ye8um/Chordial/README.md

# Chordial 🎹



## What is Chordial?

Chordial is a small, portable electronic instrument that lets you play musical chords with just a turn and a press of a knob. I wanted to create something that makes playing chords simple and fun, even for someone who doesn't know much about music theory.

Instead of having a full keyboard with dozens of keys, Chordial uses a rotary encoder to choose a chord. Once you've found the chord you want, you can press the knob to hear it play through a built-in speaker.

The whole instrument is designed to fit inside a compact 3D printed enclosure, making it easy to keep on a desk or bring around.

## Why I Made It

I've always found it interesting how different musical notes can come together to create a completely different sound. However, most musical instruments take quite a bit of practice to learn.

That gave me the idea of making an instrument that could play entire chords without needing to learn complicated finger positions.

I also wanted to challenge myself by designing my own PCB, figuring out how electronic components work together, and creating an enclosure that would make everything feel like one complete product.

Chordial combines my interests in music, electronics, programming, and 3D modeling into one project.

## How It Works

Chordial is controlled using two main inputs: a rotary encoder and a mechanical key.

Turning the rotary encoder scrolls through 24 different chords, including all 12 major chords and all 12 minor chords. The selected chord appears on a small OLED display, along with its notes and playback duration.

Pressing the rotary encoder plays the selected chord through the speaker. The sound is generated by the ESP32 and sent to a MAX98357A amplifier, which drives the speaker.

The mechanical key changes how long the chord plays. There are four duration settings: 0.5 seconds, 1 second, 2 seconds, and 4 seconds.

The goal is to make the controls simple enough that anyone can pick up Chordial and start experimenting with different sounds.

## Hardware

Chordial uses a Seeed Studio XIAO ESP32 S3 as its main microcontroller. It handles the rotary encoder, OLED display, and audio generation.

The display is a 128 × 64 SSD1306 OLED, which shows the current chord and its settings.

For sound, I chose a MAX98357A digital audio amplifier connected to an 8 ohm speaker. This allows the instrument to play multiple notes simultaneously and produce a soft, sustained synth sound.

The controls consist of an EC11 rotary encoder with a built-in push button and a Cherry MX compatible mechanical switch.

Chordial is powered by a rechargeable 3.7 V LiPo battery. It also includes a slide switch for controlling battery power, while the XIAO provides USB C connectivity.

All the electronics are designed to fit onto a custom PCB that I made in KiCad.



## Enclosure Design

I designed the enclosure in Fusion 360 with the goal of making Chordial compact, comfortable, and easy to use.

The top has openings for the OLED, rotary encoder, mechanical key, and speaker grille. I also added the Chordial name and an acoustic guitar engraving to give the instrument a little more personality.

The enclosure consists of separate top and bottom pieces that are secured using screws and nuts. The bottom contains compartments for the battery and speaker.

I also plan to use a custom 3D printed rotary knob so the instrument feels more comfortable to control.



## Software

The firmware is written in Arduino C++ for the XIAO ESP32 S3.



It reads the rotary encoder to determine which chord is selected, updates the OLED display, and generates the audio signals needed to play each chord.

Instead of relying on prerecorded audio files, Chordial generates the musical notes directly through code. This means the instrument doesn't need an SD card or stored sound samples.

The firmware currently includes 24 major and minor chords, with four selectable playback durations.

## Building Chordial

I started by creating the schematic and PCB layout in KiCad. This involved figuring out how to connect the microcontroller, amplifier, display, switches, speaker, and battery.

After finishing the PCB design, I created the enclosure in Fusion 360. I had to consider the placement and height of each component to make sure everything would fit together properly.

The firmware was then developed to control the chord selection, display, and sound generation.

The next part of the project is assembling the electronics, testing the firmware on the physical hardware, and making any adjustments needed.

## Bill of Materials

[BOM](BOM.csv)
