ye8um/Chordial/BOM.csv

Item | Qty | Supplier | Cost/item | Total Cost | link
ESP32-S3 | 1 | Seeed Studio | $7.49 | $7.49 | https://www.seeedstudio.com/XIAO-ESP32S3-p-5627.html
0.96 inch Oled Display | 1 | Aliexpress | $1.09 | $1.09 | https://www.aliexpress.us/item/3256806514513498.html
PEC11R-4220F-S0024 | 1 | Digikey | $2.69 | $2.69 | https://www.digikey.com/en/products/detail/bourns-inc/PEC11R-4220F-S0024/4499660
MAX98357A | 1 | Digikey | $4.08 | $4.08 | https://www.digikey.com/en/products/detail/analog-devices-inc-maxim-integrated/MAX98357AETE-T/4936122
Adafruit Industries-Speakers-3923 | 1 | Digikey | $5.95 | $5.95 | https://www.digikey.com/en/products/detail/adafruit-industries-llc/3885/10481842
BATTERY LITH-ION 3.7V 500MAH | 1 | Digikey | $7.95 | $7.95 | https://www.digikey.com/en/products/detail/adafruit-industries-llc/1578/5054539
Molex0532610271 | 1 | Digikey | $0.60 | $0.60 | https://www.digikey.com/en/products/detail/molex/0532610271/699094
JST-PH S2B-PH-K-S | 1 | Digikey | $0.12 | $0.12 | https://www.digikey.com/en/products/detail/jst-sales-america-inc/S2B-PH-K-S-LF-SN/455-1719-ND/926626
3D Print | 1 | Printing Legion | $11.55 | $11.55 | https://app.slack.com/client/E09V59WQY1E/C083P4FJM46
PCB | 1 | JLCPCB | $4.00 | $4.00 | https://cart.jlcpcb.com/shopcart/cartEdit/?id=09263121f535435891730e20d4ed43ed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
C0805C104K3RACTU | 1 | Digikey | $0.16 | $0.16 | https://www.digikey.com/en/products/detail/kemet/C0805C104K3RACTU/411167
0805ZD106KAT2A | 1 | Digikey | $0.26 | $0.26 | https://www.digikey.com/en/products/detail/kyocera-avx/0805ZD106KAT2A/1913257
Estimated total shipping | 1 |  |  | $19.69
