ye8um/Chordial/CAD/Base.stl

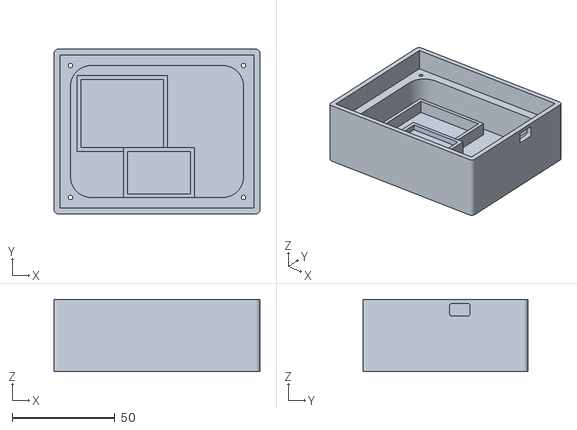
[picture p1: CAD file, 2026-10-25]
CAD/Base.stl
100.0 x 80.0 x 35.0
