ye8um/Chordial/CAD/Chordial.step

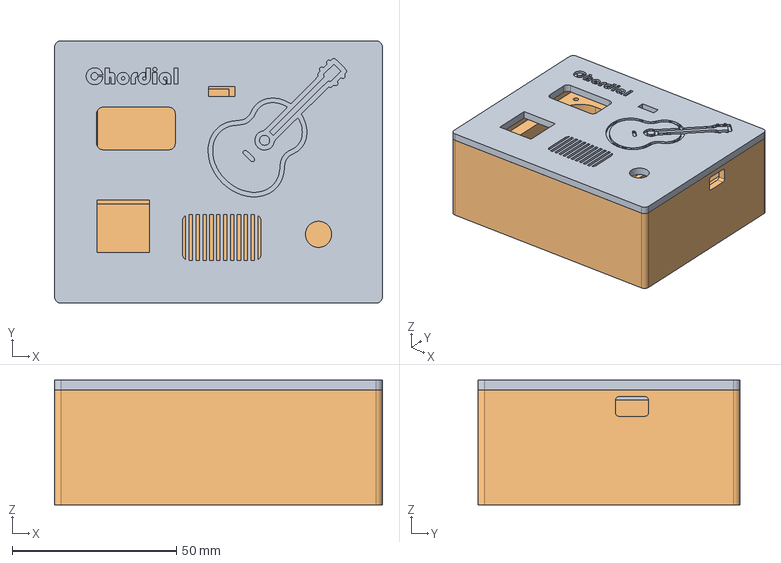
[picture p2: CAD file, 2026-10-25]
CAD/Chordial.step
100.0 x 80.0 x 38.0 mm
