ye8um/Chordial/CAD/Top.stl

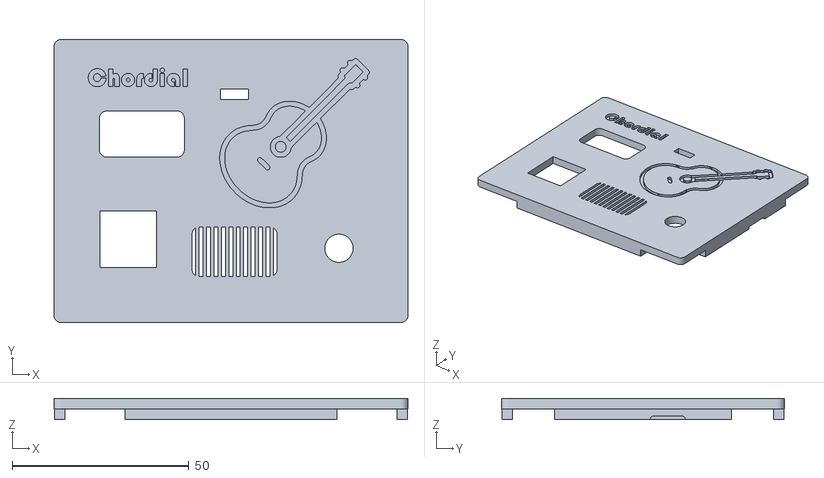
[picture p3: CAD file, 2026-10-24]
CAD/Top.stl
100.0 x 80.0 x 6.00
