ye8um/Chordial/(list of files, cad)

Other CAD files:
CAD/Chordial.f3d
CAD/Chordial.stl
