ye8um/Chordial/Hardware/Chordial.kicad_pcb

## KiCad design Hardware/Chordial.kicad_pcb (2026-10-24)

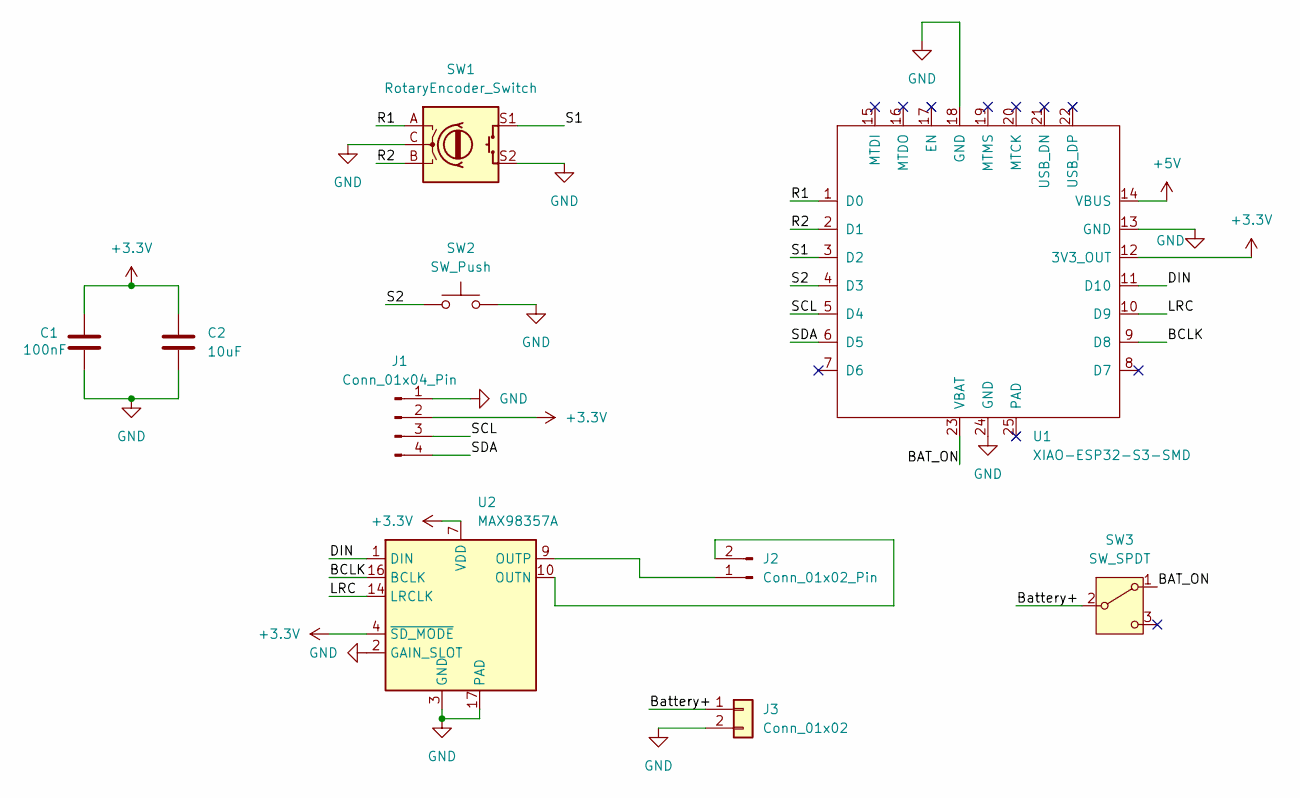
[picture p4: schematic Chordial.kicad_sch]

Parts:
C1: 100nF; C_0805_2012Metric
C2: 10uF; C_0805_2012Metric
J1: Conn_01x04_Pin; Display_128x64_096_I2C
J2: Conn_01x02_Pin; Molex_PicoBlade_53261-0271_1x02-1MP_P1.25mm_Horizontal
J3: Conn_01x02; JST_PH_S2B-PH-K_1x02_P2.00mm_Horizontal
SW1: RotaryEncoder_Switch; RotaryEncoder_Alps_EC11E-Switch_Vertical_H20mm_MountingHoles
SW2: SW_Push; SW_Cherry_MX_1.00u_PCB
SW3: SW_SPDT; SW_SPDT_Shouhan_MSK12C02
U1: XIAO-ESP32-S3-SMD
U2: MAX98357A; TQFN-16-1EP_3x3mm_P0.5mm_EP1.23x1.23mm

Connections:
+3.3V: C1.1, C2.1, J1.2, U1.12 (3V3_OUT), U2.4 (~SD_MODE), U2.7 (VDD), U2.8 (VDD)
+5V: U1.14 (VBUS)
/BAT_ON: SW3.1 (A), U1.23 (VBAT)
/BCLK: U1.9 (D8), U2.16 (BCLK)
/Battery+: J3.1, SW3.2 (B)
/DIN: U1.11 (D10), U2.1 (DIN)
/LRC: U1.10 (D9), U2.14 (LRCLK)
/R1: SW1.A, U1.1 (D0)
/R2: SW1.B, U1.2 (D1)
/S1: SW1.S1, U1.3 (D2)
/S2: SW2.1, U1.4 (D3)
/SCL: J1.3, U1.5 (D4)
/SDA: J1.4, U1.6 (D5)
GND: C1.2, C2.2, J1.1, J3.2, SW1.C, SW1.S2, SW2.2, U1.13 (GND), U1.18 (GND), U1.24 (GND), U2.2 (GAIN_SLOT), U2.3 (GND), U2.11 (GND), U2.15 (GND), U2.17 (PAD)
unnamed: J2.1, U2.9 (OUTP)
unnamed: J2.2, U2.10 (OUTN)

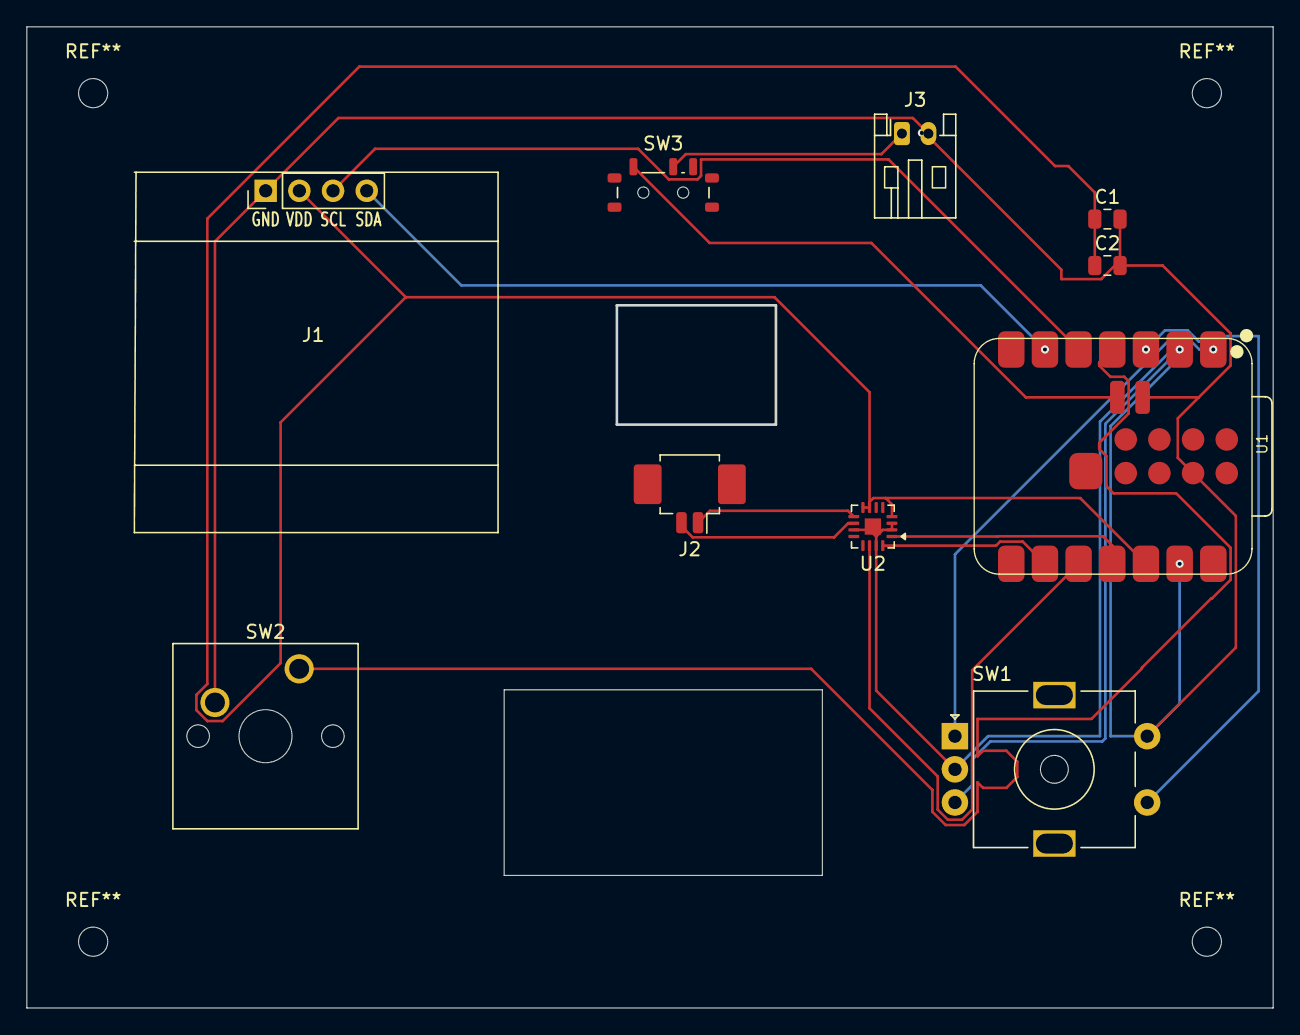
[picture p5: board Chordial.kicad_pcb from above]

Board: 2 copper layers, 94.0 x 74.0 mm, 10 parts (0 on the bottom side), 15 nets.
