ye8um/Chordial/JOURNAL.md

# Chordial – devlog

<!-- Generated by Half Life from project cmvfdd7kg000q01q7u6hxoje2. Edits here are overwritten on the next sync. -->
<!-- Generated: 2026-10-25T22:47:09.096Z -->

> [!NOTE]
> This devlog is mirrored from [Half Life](https://halflife.hackclub.com) – [open the project](https://halflife.hackclub.com/projects/cmvfdd7kg000q01q7u6hxoje2). Editing it here will not change the platform's copy, and the next sync overwrites this file.

> Handheld chord playing instrument where you rotate to choose a chord and press a button to play it.

| Week | Tier | Hours logged | Entries |
| --- | --- | --- | --- |
| Week 3 | Tier 2 | 27h | 9 |

## Contents

1. [2026-10-19 – October 19th: Idea set](#2026-10-19-october-19th-idea-set)
2. [2026-10-20 – October 20th: PCB](#2026-10-20-october-20th-pcb)
3. [2026-10-21 – October 21st: Battery system started](#2026-10-21-october-21st-battery-system-started)
4. [2026-10-22 – October 22nd: Massive change](#2026-10-22-october-22nd-massive-change)
5. [2026-10-23 – October 23th: PCB basically done.](#2026-10-23-october-23th-pcb-basically-done)
6. [2026-10-24 – October 24th: PCB DONE FINALLY](#2026-10-24-october-24th-pcb-done-finally)
7. [2026-10-24 – October 24th: 3D Case DONE!](#2026-10-24-october-24th-3d-case-done)
8. [2026-10-24 – October 24th: Parts](#2026-10-24-october-24th-parts)
9. [2026-10-25 – October 25th: Firmware done](#2026-10-25-october-25th-firmware-done)

## Design

### 2026-10-19 – October 19th: Idea set

**2h**

October 19th: Idea set

Instruments. Instruments are nice to listen and most like guitar and piano do one thing. Playing chords. Playing chords is essential when trying to play a piece or sing along to a song. This is why I designed Chordial.



Electronics used
XIAO ESP32-C3
MAX98357A  amplifier
speaker
SSD1306 OLED
EC11 rotary encoder
 2 momentary push buttons


Then set up github repository. Then made the Kicad File. Ready to work tomorrow.

### 2026-10-20 – October 20th: PCB

**3h**

October 20th: PCB

Today I started my day finding all the parts that I needed and looked up how to use them in KiCAD

I decided to use the Seedstudio Xiao ESP32-S3  because it has a bit more pins than ESP32-C3.



Then I went researching for the audio amplifier and landed on this. And searched up how to wire them.



I am definitely getting better at wiring things in KiCAD and finished the rest of all the things I needed.



Basic part done. I am going to ask how to implement a battery system because I can't find a good guide online.

### 2026-10-21 – October 21st: Battery system started

**3h**

October 21st: Battery system started

Okay I first posted a help message on the halflife help channel yesterday about how to add a recharging system but no one responded. So I posted it again and luckily Dipa responded and gave me guidance.



So using the frame work Dipa has given me, I looked up a similar project online that has a battery system.



Used both of these guidance for reference for my own project and ended up with something like this.



I added the USB-C adapter and MCP73871 as the charger system. Also added where the battery should charge and hopefully I can finish this complicated system tomorrow.

### 2026-10-22 – October 22nd: Massive change

**3h**

October 22nd: Massive change

So, I was continuing the complex battery system I was working on last time and I received a message from slack from someone that ESP32-S3 might have a built in battery system. So I went on the wiki for this.



And read that there is a battery system and I changed my whole design to use the built in battery because I wasn't too sure if my complex battery system would work and it was adding extra work for soldering.



I finalized the implementation and bug checked and went online and researched to put the correct footprints for each part.



Schematic done, going to finish the pcb design tomorrow hopefully.

### 2026-10-23 – October 23th: PCB basically done.

**4h**

October 23th: PCB basically done.

Today I was sick so my work pace was drastically slow because I kept coughing.



First I changed the battery system so that they had pins to the actual board and I will be able to connect the battery pretty easy to the PCB using mounted soldering boards. Also I added a switch for on and off function.

Then, when I tried to add it to PCB editor, I had to add a footprint for everything and apparently the ESP32-S3 that I put using symbol editor didn't have a footprint, so I found that and added that in.



Then added all the components and arranged it in a style I want (Probably going to change a bit because I want to make sure the physical part have enough space).



Then added the wires in and started debugging all the errors. Using DRC





Added everything in except the actual pcb layout. Did not decide on that yet so hopefully I get better tomorrow so I can lock in.

### 2026-10-24 – October 24th: PCB DONE FINALLY

**3h**

October 24th: PCB DONE FINALLY

Today I added a mounting holes so I can mount the pcb to my later future 3D case design.



I added the enclosure of the PCB.



I added hole for the wire and another hole for the speaker sound to go through. Also changed my spekaer connection to the actual connector.



Then I realized the battery connector also had a specific connection. So I changed that.



Finalized and these are the finished schematic and 3D design.





### 2026-10-24 – October 24th: 3D Case DONE!

**4h**

October 24th: 3D Case DONE!

I first exported the finished PCB design as a .step file and export it to fusion.



Then added a basic layout of the walls of the case.



I extruded this out and added holes on the bottom where the screws and nuts will go.



Then I added place where the PCB will be placed. Added compartments for the speaker and the battery.



Added the top and decorated.



Added USBC hole and finished the 3D design.



### 2026-10-24 – October 24th: Parts

**2h**

October 24th: Parts

I was finding all the parts online. Found it all but realized the shipping cost a lot. So I changed it to almost all to be in the website DigiKey so that my shipping cost would be drastically lowered.



Also setuped my github repository except the firmware I didn't work on yet. Also my battery compartment had the wrong measurements so I had to change that. Submitted my 3D design to printing legion too.



### 2026-10-25 – October 25th: Firmware done

**3h**

October 25th: Firmware done

Today I woke up still sick and searched on internet how to use each component and code it in arduino. Mainly I spent a long time researching about MAX98357A because I have never used it in my life.



I found codes and examples like that online through sites like cirkit designer or github. Then I got started on my coding. I did the basic shape and added in all the components that was needed for my project to work by searching up on Google and watching YT videos about how to use them. I think the biggest thing I learned that you can print text on the OLED display and it doesnt always have to be a sprite. I guess that kind of makes sense but I just didn't think of that.



After coding and debugging with help of AI, I finished the firmware :D
