ye8um/Chordial/(commit log)

2026-10-25 Update README with images and additional details
    Added images and expanded sections on enclosure design and software functionality.
2026-10-25 Revise README to include Bill of Materials
    Updated the README to replace 'Final Thoughts' section with 'Bill of Materials' link.
